MatanPazi/VFD/References/Motor_Wiring_Diagram.jpg

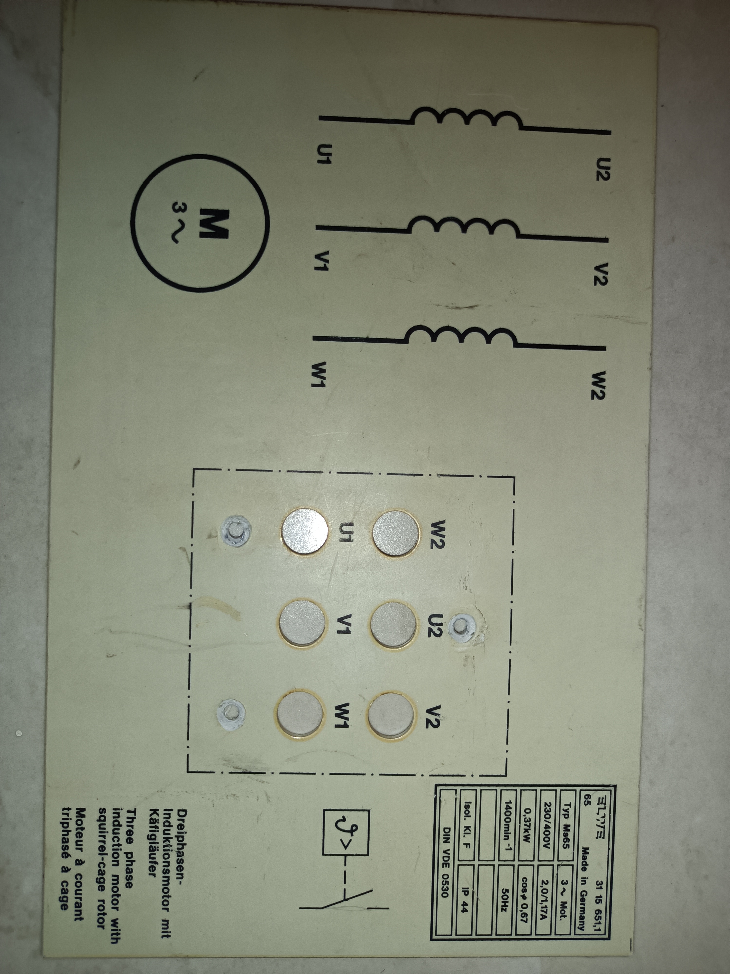
References/Motor_Wiring_Diagram.jpg
