MatanPazi/VFD/README.md

# Code for DIY Variable Frequency Drive

Check out a series of videos I made on the project:  
[How to make a Variable Frequency Drive (VFD) | 1: Overview & Basics](https://youtu.be/XGlXLaUbKLw)  
[How to make a Variable Frequency Drive (VFD) | 2: Hardware Design](https://youtu.be/wUGCEtSXV1I)  
[How to make a Variable Frequency Drive (VFD) | 3: Software](https://youtu.be/HGHpkghiIs8)
