MatanPazi/VFD/VFD_Prototype_Schematics.pdf

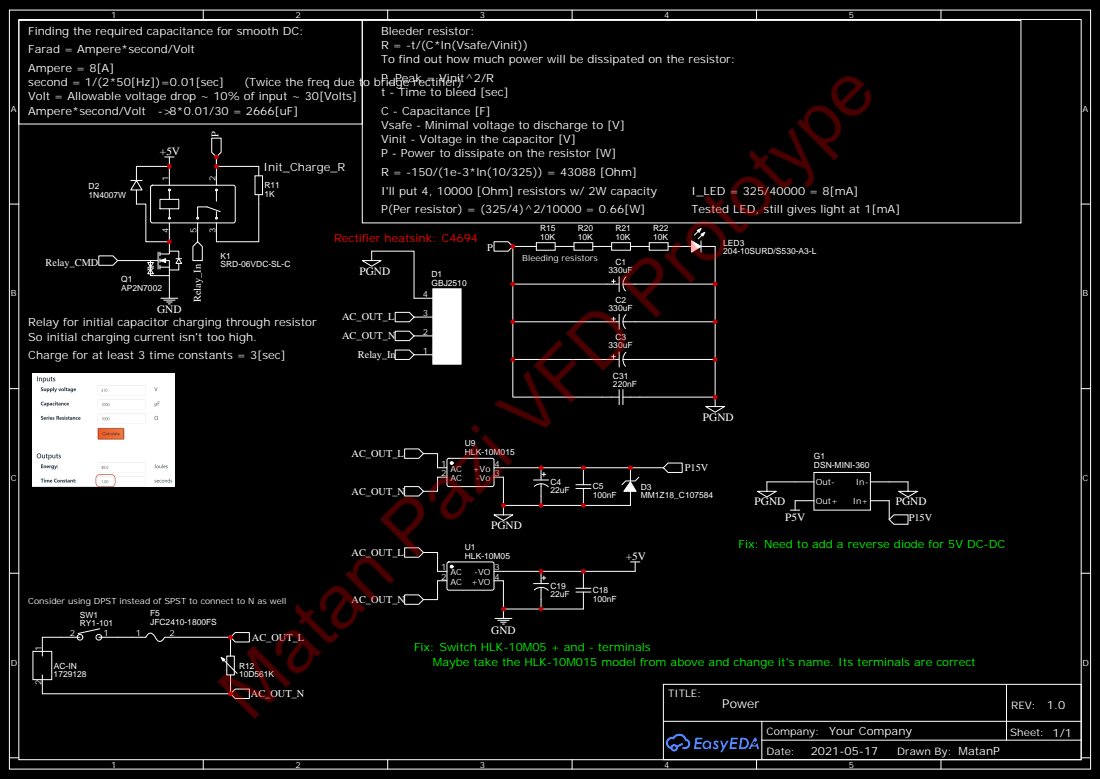
[picture p2: page 1]

Finding the required capacitance for smooth DC:
Farad = Ampere*second/Volt
Ampere = 8[A]
Volt = Allowable voltage drop ~ 10% of input ~ 30[Volts]
Ampere*second/Volt ->

Bleeder resistor:
R = -t/(C*ln(Vsafe/Vinit))
To find out how much power will be dissipated on the resistor:
P_Peak = Vinit^2/R
t - Time to bleed [sec]
C - Capacitance [F]
Vsafe - Minimal voltage to discharge to [V]
Vinit - Voltage in the capacitor [V]
P - Power to dissipate on the resistor [W]
R = -150/(1e-3*ln(10/325)) = 43088 [Ohm]
I'll put 4, 10000 [Ohm] resistors w/ 2W capacity
P(Per resistor) = (325/4)^2/10000 = 0.66[W]

I_LED = 325/40000 = 8[mA]
Tested LED, still gives light at 1[mA]

Relay for initial capacitor charging through resistor
So initial charging current isn't too high.
Charge for at least 3 time constants = 3[sec]

Fix: Need to add a reverse diode for 5V DC-DC

Consider using DPST instead of SPST to connect to N as well

Fix: Switch HLK-10M05 + and - terminals
Maybe take the HLK-10M015 model from above and change it's name. Its terminals are correct

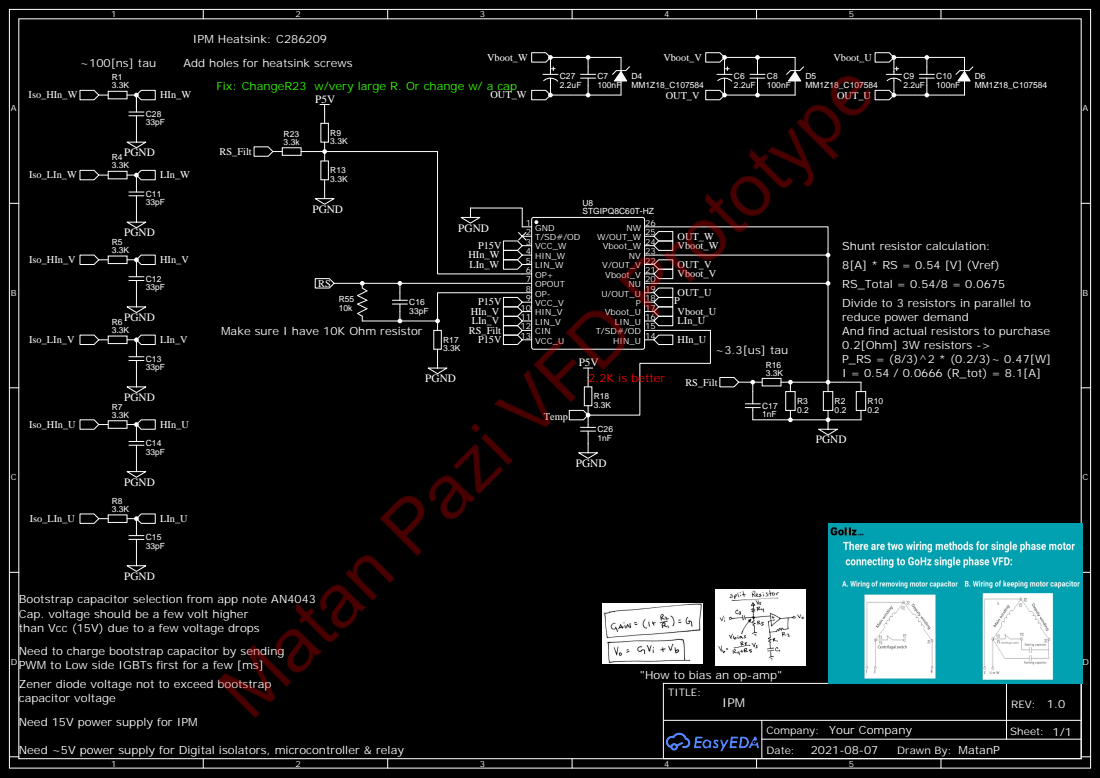
[picture p3: page 2]

IPM Heatsink: C286209
Add holes for heatsink screws
Fix: ChangeR23 w/very large R. Or change w/ a cap

Shunt resistor calculation:
8[A] * RS = 0.54 [V] (Vref)
RS_Total = 0.54/8 = 0.0675
Divide to 3 resistors in parallel to
reduce power demand
And find actual resistors to purchase
0.2[Ohm] 3W resistors ->
I = 0.54 / 0.0666 (R_tot) = 8.1[A]

Make sure I have 10K Ohm resistor

Bootstrap capacitor selection from app note AN4043
Cap. voltage should be a few volt higher
than Vcc (15V) due to a few voltage drops
Need to charge bootstrap capacitor by sending
PWM to Low side IGBTs first for a few [ms]
Zener diode voltage not to exceed bootstrap
capacitor voltage
Need 15V power supply for IPM

"How to bias an op-amp"
TITLE:

Need ~5V power supply for Digital isolators, microcontroller & relay

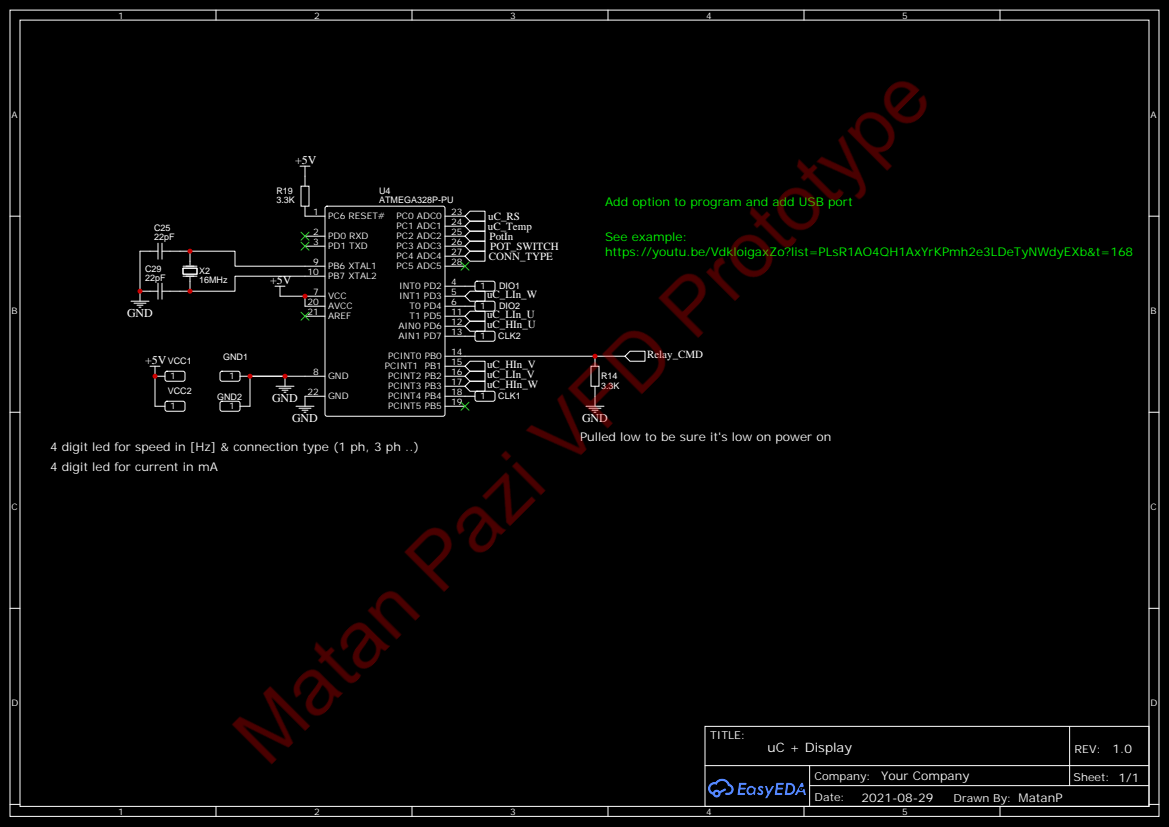
[picture p4: page 3]
TITLE:; uC + Display; REV: 1.0; uC_LIn_W; uC_LIn_V; uC_HIn_V; uC_HIn_U; uC_LIn_U; ATMEGA328P-PU; PC6 RESET# 1; PD0 RXD 2 PD1 TXD 3; INT0 PD2 4 INT1 PD3 5 T0 PD4 6; VCC 7; GND 8; PB6 XTAL1 9 PB7 XTAL2 10; T1 PD5 11 AIN0 PD6 12 AIN1 PD7 13; PCINT0 PB0 14 PCINT1 PB1 15 PCINT2 PB2 16 PCINT3 PB3 17 PCINT4 PB4 18 PCINT5 PB5 19; AVCC 20 AREF 21; GND 22; PC0 ADC0 23 PC1 ADC1 24 PC2 ADC2 25 PC3 ADC3 26 PC4 ADC4 27 PC5 ADC5 28; uC_HIn_W; GND; GND1; VCC1 1 VCC2 1; GND2 1; DIO2; 1 CLK2; Relay_CMD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

Add option to program and add USB port

See example:
https://youtu.be/VdkloigaxZo?list=PLsR1AO4QH1AxYrKPmh2e3LDeTyNWdyEXb&t=168

GND
Pulled low to be sure it's low on power on

4 digit led for speed in [Hz] & connection type (1 ph, 3 ph ..)
4 digit led for current in mA

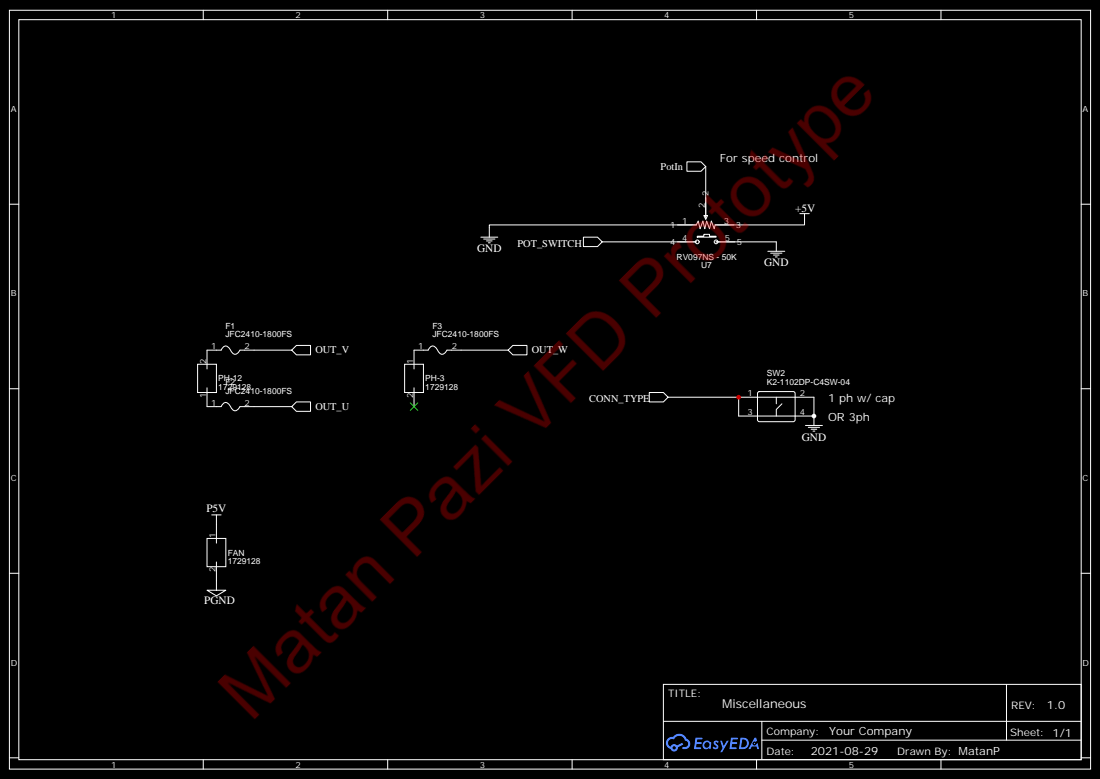
[picture p5: page 4]
TITLE:; Miscellaneous; REV: 1.0; GND; PotIn; OUT_V; OUT_U; OUT_W; POT_SWITCH; FAN; 1 ph w/ cap OR 3ph; CONN_TYPE; PGND; JFC2410-1800FS

For speed control

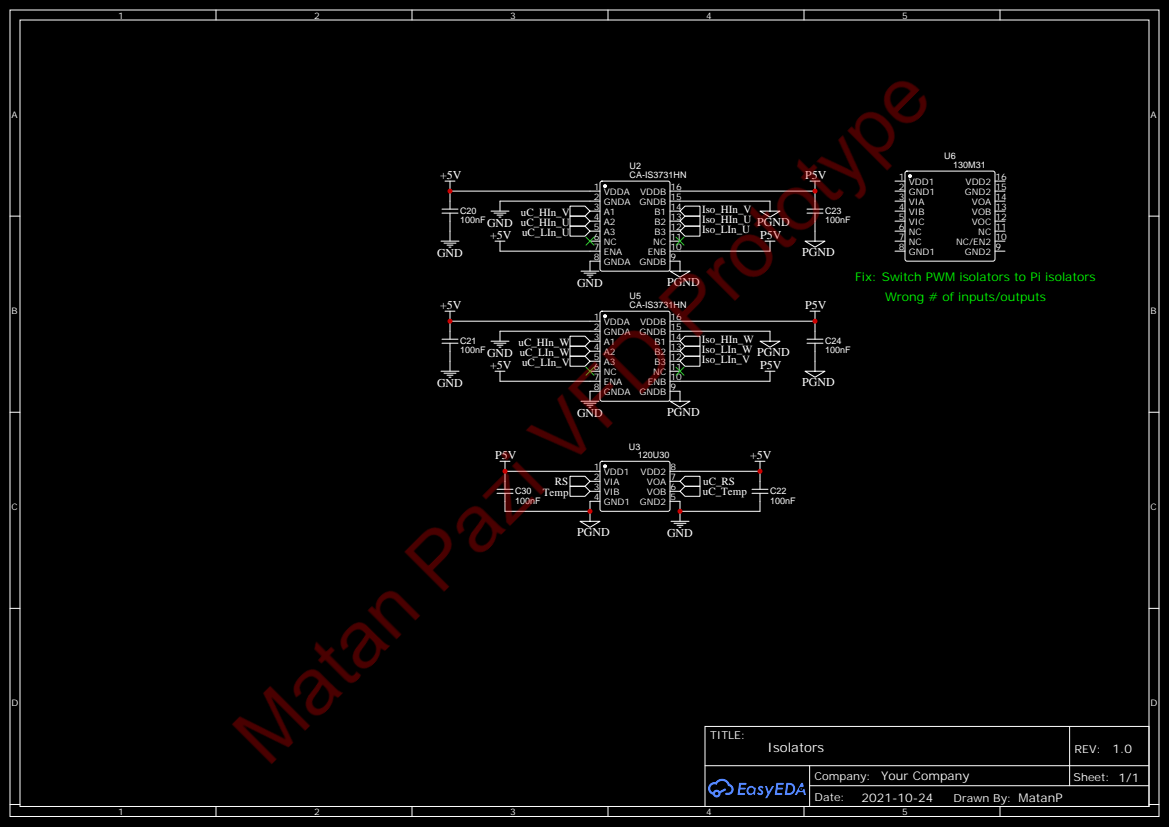
[picture p6: page 5]

Fix: Switch PWM isolators to Pi isolators
Wrong # of inputs/outputs
