MatanPazi/VFD/(commit log)

2022-01-12 Config PWM in setup()
2022-05-14 Move initial relay 3 sec delay from loop to setup.
2022-05-14 Set the output pin to the relay high after ~3 sec
2022-05-14 Change SHORT_WAIT to RELAY_CHARGE_WAIT
    [VFD.ino]
2022-07-14 Prevent going outside 0-255 range due to deadtime when using Amp < 1.0
    The sine table was built so +-2DT won't result in exceeding the uint8 range with Amp = 1.0
    However, w/ Amp < 1.0, -2DT might cause a negative number.
    So saturating this scenario to 0.
    [VFD.ino]
2022-07-21 Fixed disabled PWM values for low side
    [VFD.ino]
2022-07-21 Set PWM values to uint8
2022-10-09 Updated #defines time (Relay, click)
2022-10-10 Accidentally erased Timer1
2022-10-10 Updated Todo. PWM not in sync
2022-10-10 Updated Todo. Can't recreate low freq problem.
    [VFD.ino]
2022-10-10 Update Todo. RC filter description
2022-10-13 Zero PWM counter in PWM config just in case.
2022-10-13 Small data type changes.
    For 100 Hz desired freq, getting 17 consecutive same values instead of the expected 10.
    Trying to find out why.
2022-10-13 Allow for higher freq to compensate for bug.
    Temporary fix
    [VFD.ino]
2022-10-14 Exceeding interrupt time. Updated Todo
    I noticed that I don't get a change in the PWM compare values as often as I'd expect (Using scope).
    E.g chaning every 15 interrupts instead of every 10 for desired freq of 100[Hz].
    I removed most of the interrupt and just toggled compare values at different intervals and it worked well.
    So, I assume I'm exceeding my interrupt time.
    Need to reduce interrupt time.
2022-10-14 Perform division outside of interrupt
    Reduce interrupt time.
2022-10-14 Move boot cap charge time out of interrupt
2022-10-14 Removed if from interrupt
2022-10-14 Removed an if in the interrupt
2022-10-14 Updated Todo. Improving interrupt time is helping
2022-10-14 Calculating Amp*sine out of interrupt
2022-10-14 Reverting commit. didn't compile.
    [VFD.ino]
2022-10-14 Revert to before uniting index indices
    [VFD.ino]
2022-10-17 Revert back to if. Modulo is probably slower.
    [VFD.ino]
2022-10-19 To do: Isolator LPF causing potential issues?
    [VFD.ino]
2022-10-20 Added min PWM value due to isolator response time.
2022-10-22 Update To do, FTDI programming error.
    [VFD.ino]
2022-11-12 Update relay on wait time
2022-11-12 Increased relay on time a bit more just in case
2022-11-21 Critical bug, updated Todo
    [VFD.ino]
2022-11-22 Disable PWM is configured differently.
2022-11-26 Fixed critical bug. Overwrote PWM pin output conf.
    [VFD.ino]
2023-01-22 Setting OVF_Counter_Compare to volatile
    It is calculated in the main loop and used in the interrupt.
    Set volatile In case the interrupt is executed in the middle of setting this variable.
2023-04-20 Added VFD schematics
2023-05-28 Fixed bug after Desired_Freq was changed to local var
    [VFD.ino]
2023-07-30 Added motor wiring diagram
2023-11-09 Added voltage amplitude
2023-11-17 Updated motor parameters
